audiodestrukt/flexisette/pcb-rerun/index.circuit.kicad_pcb

## KiCad design pcb-rerun/index.circuit.kicad_pcb (2026-10-05)

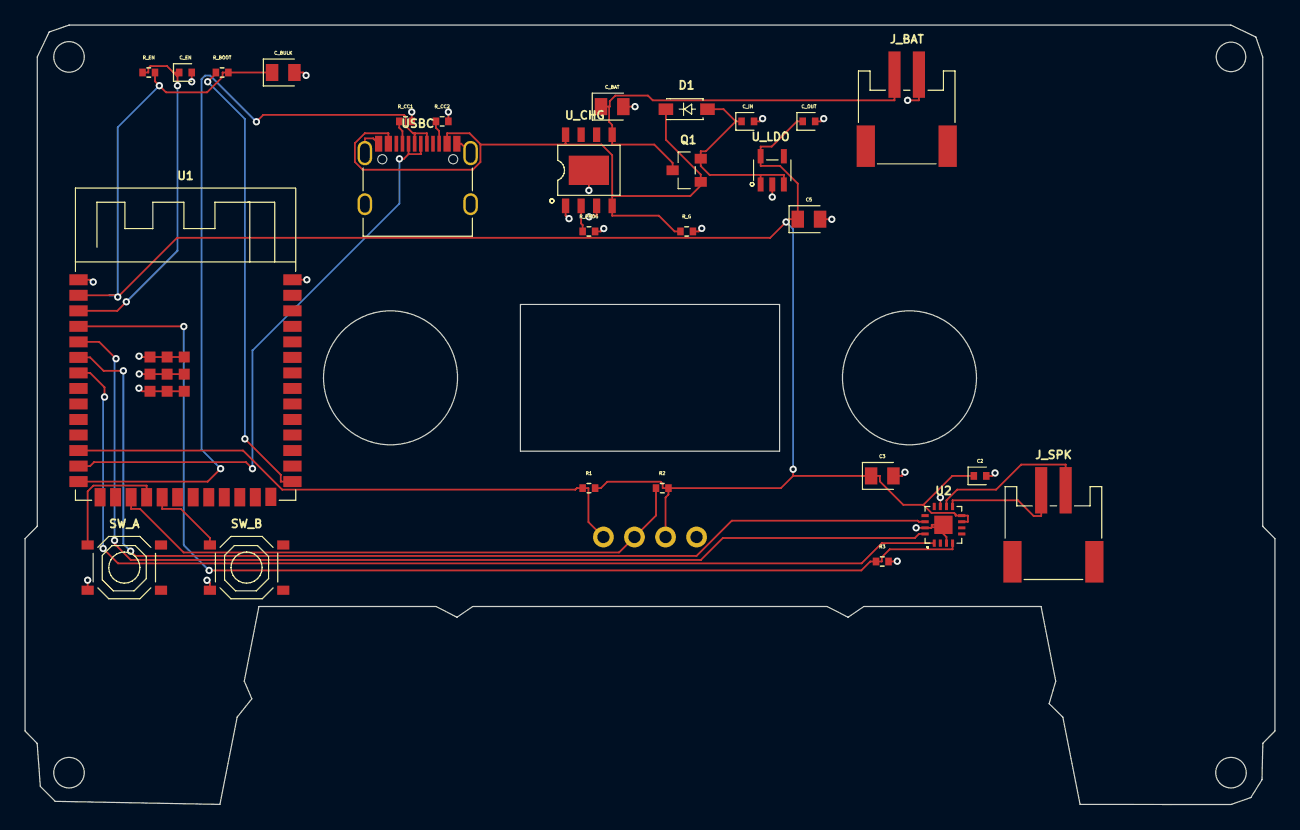
[picture p2: board index.circuit.kicad_pcb from above]

Board: 2 copper layers, 102.2 x 63.8 mm, 30 parts (0 on the bottom side), 22 nets.

Parts:
C1, C2: 100nF; capacitor_0402
C3: 10uF; capacitor_0805
C5: 22uF; capacitor_0805
C_BAT: 10uF; capacitor_0805
C_BULK: 22uF; capacitor_0805
C_EN: 100nF; capacitor_0402
C_IN: 1uF; capacitor_0402
C_OUT: 1uF; capacitor_0402
D1: D; B5819W_SL
J_BAT: S2B_PH_SM4_TB_LF__SN_; S2B_PH_SM4_TB_LF_SN
J_SPK: S2B_PH_SM4_TB_LF__SN_; S2B_PH_SM4_TB_LF_SN
OLED: chip
Q1: AO3401A
R1, R2: 4.7kΩ; resistor_res0402
R3: 100kΩ; resistor_res0402
R_BOOT: 10kΩ; resistor_res0402
R_CC1, R_CC2: 5.1kΩ; resistor_res0402
R_EN: 10kΩ; resistor_res0402
R_G: 100kΩ; resistor_res0402
R_PROG: 2kΩ; resistor_res0402
SW_A: TS_1187A_B_A_B
SW_B: TS_1187A_B_A_B
U1: ESP32_S3_WROOM_1_N16R8
U2: MAX98357AETE_T
USBC: TYPE_C_31_M_12
U_CHG: TP4056_42_ESOP8
U_LDO: ME6211C33M5G_N

Connections:
BCK: U1.5, U2.16
DIN: U1.7, U2.1
GND: C1.2, C2.2, C3.2, C5.2, C_BAT.2, C_BULK.2, C_EN.2, C_IN.2, C_OUT.2, J_BAT.2, OLED.1, R3.2, R_CC1.2, R_CC2.2, R_G.2, R_PROG.2, SW_A.3, SW_B.3, U1.1, U1.40, U1.41, U1.42, U1.43, U1.44, U1.45, U1.46, U1.47, U1.48, U1.49, U2.3, U2.11, U2.15, U2.17, USBC.1, USBC.2, USBC.3, USBC.4, USBC.13, USBC.14, U_CHG.1, U_CHG.3, U_CHG.9, U_LDO.2
SCL: OLED.3, R2.1, U1.17
SD: R3.1, U1.4, U2.4
SDA: OLED.4, R1.1, U1.12
U1.EN to R_EN.pin1: C_EN.1, R_EN.1, U1.3
U1.IO0 to R_BOOT.pin1: R_BOOT.1, U1.27
U1.IO10 to SW_A.A: SW_A.1, U1.18
U1.IO11 to SW_B.A: SW_B.1, U1.19
U2.OUTN to J_SPK.pin2: J_SPK.2, U2.10
U2.OUTP to J_SPK.pin1: J_SPK.1, U2.9
USBC.A5 to R_CC1.pin1: R_CC1.1, USBC.6
USBC.B5 to R_CC2.pin1: R_CC2.1, USBC.12
USB_DM: U1.13, USBC.7, USBC.9
USB_DP: U1.14, USBC.8, USBC.10
U_CHG.PROG to R_PROG.pin1: R_PROG.1, U_CHG.2
V3V3: C1.1, C2.1, C3.1, C5.1, C_BULK.1, C_OUT.1, OLED.2, R1.2, R2.2, R_BOOT.2, R_EN.2, U1.2, U2.7, U2.8, U_LDO.5
VBAT: C_BAT.1, J_BAT.1, Q1.3, U_CHG.5
VBUS: D1.1, Q1.1, R_G.1, USBC.15, USBC.16, U_CHG.4, U_CHG.8
VSYS: C_IN.1, D1.2, Q1.2, U_LDO.1, U_LDO.3
WS: U1.6, U2.14
